star-waroobah/Skyline/README.md

# Skyline





Skyline is a custom flight controller for a quadcopter drone using the STM32F722 microcontroller. It will act as the brain of the drone.

I made this as the half life week 5 project.

## Features

- **STM32F722RET6 MCU** with 25 MHz and 32.768 kHz crystals, plus reset and boot buttons
- **USB-C port** for power and programming
- **4 motor outputs** (PA0–PA3) through one 8-pin 4-in-1 ESC header
- **Receiver header** (UART, 3.3 V) for ELRS or similar radios
- **Battery voltage monitoring**, with the divider sized for a 4S battery
- **SWD header** as a backup way to flash firmware
- **Plug-in IMU (SPI) and barometer (I2C) headers** for breakout boards
- **microSD slot** for flight logging
- **Dual power input:** two SS34 diodes let the board run from USB or the battery
- **LMR51430 3.3 V buck regulator** that accepts up to 36 V in
- **Hand-solderable:** 0603 and 0805 parts and 2.54 mm headers

## How it works

It uses an IMU sensor to detect movement and orientation and a barometer to estimate altitude. The board receive commands from a radio receiver and send signals to four ESCs to control the motors and help keep the drone stable. It also have USB-C for connectivity, a microSD card for flight data logging, and battery voltage monitoring. 

## PCB
Screenshot (659)

## Schematic


## 3D View



## Bill of Materials

Full BOM: [`hardware/BOM.csv`](hardware/BOM.csv)

| Part | Qty | Notes |
|---|-----|---|
| [Microcontroller] | 1 | |
| [IMU / sensor] | 1 | |
| [Motors] | 4 | |
| [ESCs / motor drivers] | 4 | |
| [Battery] | 1 | |
| [Frame] | 1 | |

## Credits

- Symbols and footprints from EasyKiCad2 / EasyEDA converted libraries (included in `hardware/`).
- I also took guidance from the Hack Club guide (https://blueprint.hackclub.com/starter-projects/flightcontroller)
