star-waroobah/Skyline/hardware/skyline.kicad_pcb

## KiCad design hardware/skyline.kicad_pcb (2026-11-08)

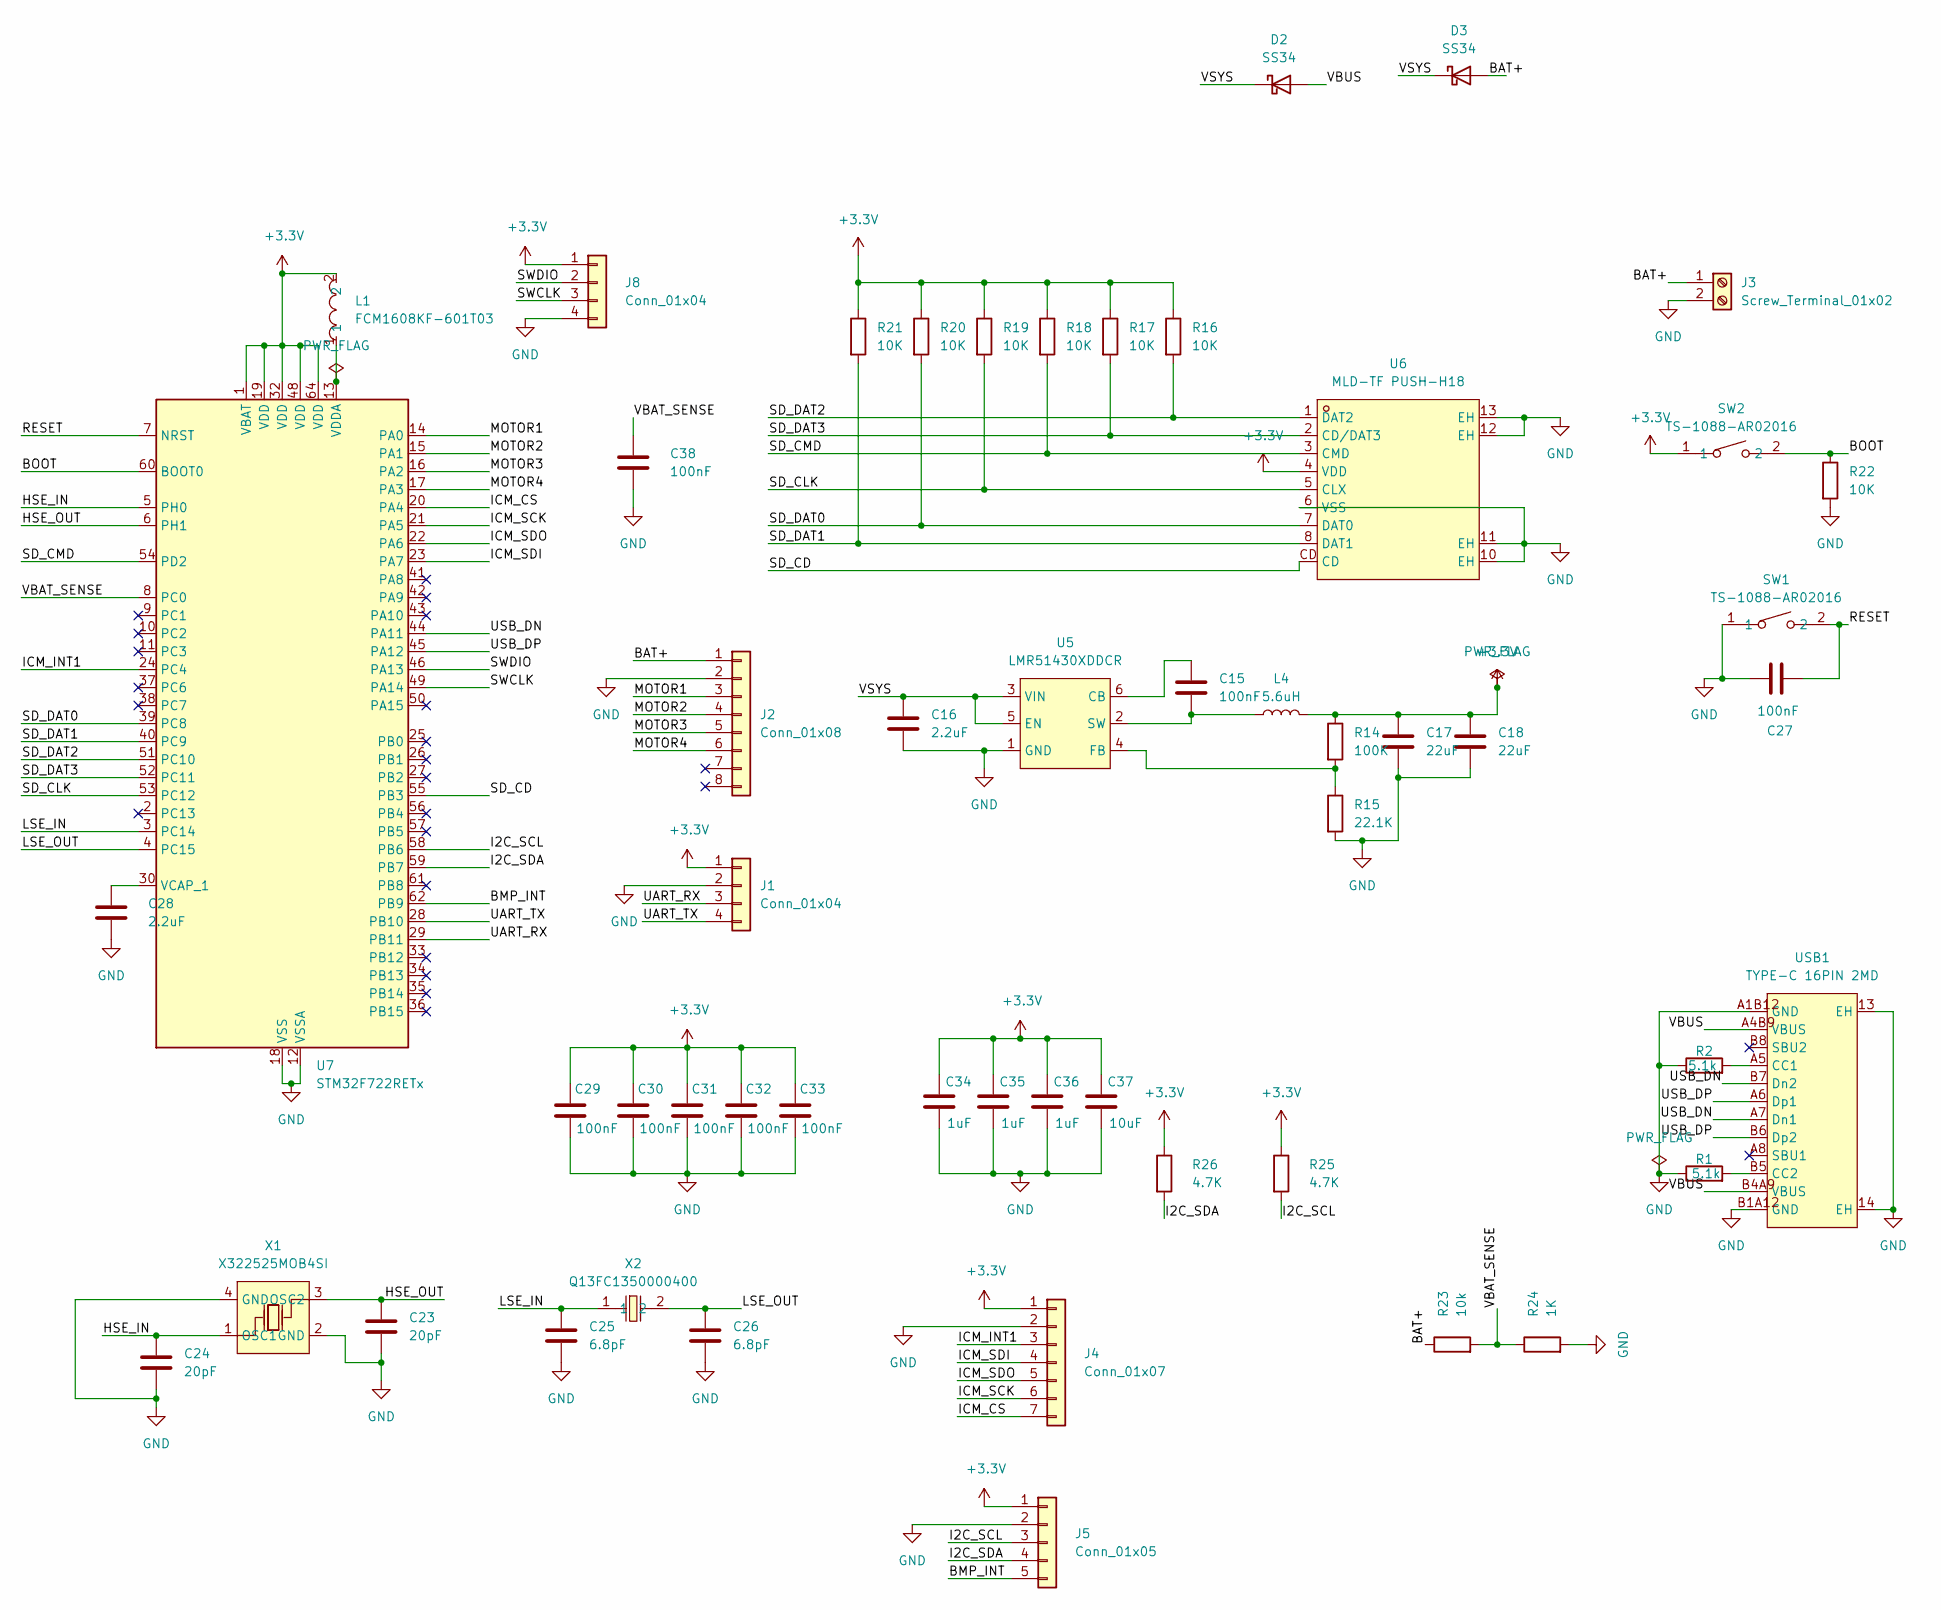
[picture p1: schematic skyline.kicad_sch]

Parts:
C15, C27, C29, C30, C31, C32, C33: 100nF; C_0603_1608Metric
C16, C28: 2.2uF; C_0603_1608Metric
C17, C18: 22uF; C_0603_1608Metric
C23, C24: 20pF; C_0603_1608Metric
C25, C26: 6.8pF; C_0603_1608Metric
C34, C35, C36: 1uF; C_0805_2012Metric
C37: 10uF; C_0603_1608Metric
C38: 100nF; C_0805_2012Metric
D2, D3: SS34; D_SMA
J1, J8: Conn_01x04; PinHeader_1x04_P2.54mm_Vertical
J2: Conn_01x08; PinHeader_1x08_P2.54mm_Vertical
J3: Screw_Terminal_01x02; TerminalBlock_Xinya_XY308-2.54-2P_1x02_P2.54mm_Horizontal
J4: Conn_01x07; PinHeader_1x07_P2.54mm_Vertical
J5: Conn_01x05; PinHeader_1x05_P2.54mm_Vertical
L1: FCM1608KF-601T03; L0603; MPN FCM1608KF-601T03; LCSC Part C141723
L4: 5.6uH; IND-SMD_L3.0-W3.0
R1, R2: 5.1k; R_0603_1608Metric
R14: 100K; R_0603_1608Metric
R15: 22.1K; R_0603_1608Metric
R16, R17, R18, R19, R20, R21, R22: 10K; R_0603_1608Metric
R23: 10k; R_0603_1608Metric
R24: 1K; R_0603_1608Metric
R25, R26: 4.7K; R_0603_1608Metric
SW1, SW2: TS-1088-AR02016; SW-SMD_L3.9-W3.0-P4.45; MPN TS-1088-AR02016; LCSC Part C720477
U5: LMR51430XDDCR; SOT-23-6_L2.9-W1.6-P0.95-LS2.8-BL; MPN LMR51430XDDCR; LCSC Part C5185863
U6: MLD-TF PUSH-H18; SD-SMD_MLD-TF-PUSH-H18; MPN MLD-TF PUSH-H18; LCSC Part C52750848
U7: STM32F722RETx; LQFP-64_10x10mm_P0.5mm
USB1: TYPE-C 16PIN 2MD; USB-C-SMD_TYPE-C-16PIN-2MD-073; MPN TYPE-C 16PIN 2MD(073); LCSC Part C2765186
X1: X322525MOB4SI; CRYSTAL-SMD_4P-L3.2-W2.5-BL; MPN X322525MOB4SI; LCSC Part C9006
X2: Q13FC1350000400; FC-135R_L3.2-W1.5; MPN Q13FC13500004; LCSC Part C32346

Connections:
+3.3V: C17.1, C18.1, C29.1, C30.1, C31.1, C32.1, C33.1, C34.1, C35.1, C36.1, C37.1, J1.1, J4.1, J5.1, J8.1, L1.2, L4.2, R14.1, R16.1, R17.1, R18.1, R19.1, R20.1, R21.1, R25.1, R26.1, SW2.1, U6.4 (VDD), U7.1 (VBAT), U7.19 (VDD), U7.32 (VDD), U7.48 (VDD), U7.64 (VDD)
/<NO NET>: D2.2 (A), USB1.A4B9 (VBUS), USB1.B4A9 (VBUS)
/BAT+: D3.2 (A), J2.1, J3.1, R23.1
/BMP_INT: J5.5, U7.62 (PB9)
/BOOT: R22.1, SW2.2, U7.60 (BOOT0)
/HSE_IN: C24.1, U7.5 (PH0), X1.1 (OSC1)
/HSE_OUT: C23.1, U7.6 (PH1), X1.3 (OSC2)
/I2C_SCL: J5.3, R25.2, U7.58 (PB6)
/I2C_SDA: J5.4, R26.2, U7.59 (PB7)
/ICM_CS: J4.7, U7.20 (PA4)
/ICM_INT1: J4.3, U7.24 (PC4)
/ICM_SCK: J4.6, U7.21 (PA5)
/ICM_SDI: J4.4, U7.23 (PA7)
/ICM_SDO: J4.5, U7.22 (PA6)
/LSE_IN: C25.1, U7.3 (PC14), X2.1
/LSE_OUT: C26.1, U7.4 (PC15), X2.2
/MOTOR1: J2.3, U7.14 (PA0)
/MOTOR2: J2.4, U7.15 (PA1)
/MOTOR3: J2.5, U7.16 (PA2)
/MOTOR4: J2.6, U7.17 (PA3)
/RESET: C27.1, SW1.2, U7.7 (NRST)
/SD_CD: U6.CD, U7.55 (PB3)
/SD_CLK: R19.2, U6.5 (CLX), U7.53 (PC12)
/SD_CMD: R18.2, U6.3 (CMD), U7.54 (PD2)
/SD_DAT0: R20.2, U6.7 (DAT0), U7.39 (PC8)
/SD_DAT1: R21.2, U6.8 (DAT1), U7.40 (PC9)
/SD_DAT2: R16.2, U6.1 (DAT2), U7.51 (PC10)
/SD_DAT3: R17.2, U6.2 (CD/DAT3), U7.52 (PC11)
/SWCLK: J8.3, U7.49 (PA14)
/SWDIO: J8.2, U7.46 (PA13)
/UART_RX: J1.3, U7.29 (PB11)
/UART_TX: J1.4, U7.28 (PB10)
/USB_DN: U7.44 (PA11), USB1.A7 (Dn1), USB1.B7 (Dn2)
/USB_DP: U7.45 (PA12), USB1.A6 (Dp1), USB1.B6 (Dp2)
/VBAT_SENSE: C38.1, R23.2, R24.1, U7.8 (PC0)
/VSYS: C16.1, D2.1 (K), D3.1 (K), U5.3 (VIN), U5.5 (EN)
GND: C16.2, C17.2, C18.2, C23.2, C24.2, C25.2, C26.2, C27.2, C28.2, C29.2, C30.2, C31.2, C32.2, C33.2, C34.2, C35.2, C36.2, C37.2, C38.2, J1.2, J2.2, J3.2, J4.2, J5.2, J8.4, R1.1, R2.1, R15.2, R22.2, R24.2, SW1.1, U5.1 (GND), U6.6 (VSS), U6.10 (EH), U6.11 (EH), U6.12 (EH), U6.13 (EH), U7.12 (VSSA), U7.18 (VSS), U7.31 (VSS), U7.47 (VSS), U7.63 (VSS), USB1.13 (EH), USB1.14 (EH), USB1.A1B12 (GND), USB1.B1A12 (GND), X1.2 (GND), X1.4 (GND)
unnamed: C15.1, U5.6 (CB)
unnamed: R14.2, R15.1, U5.4 (FB)
unnamed: C15.2, L4.1, U5.2 (SW)
unnamed: C28.1, U7.30 (VCAP_1)
unnamed: L1.1, U7.13 (VDDA)
unnamed: R2.2, USB1.A5 (CC1)
unnamed: R1.2, USB1.B5 (CC2)

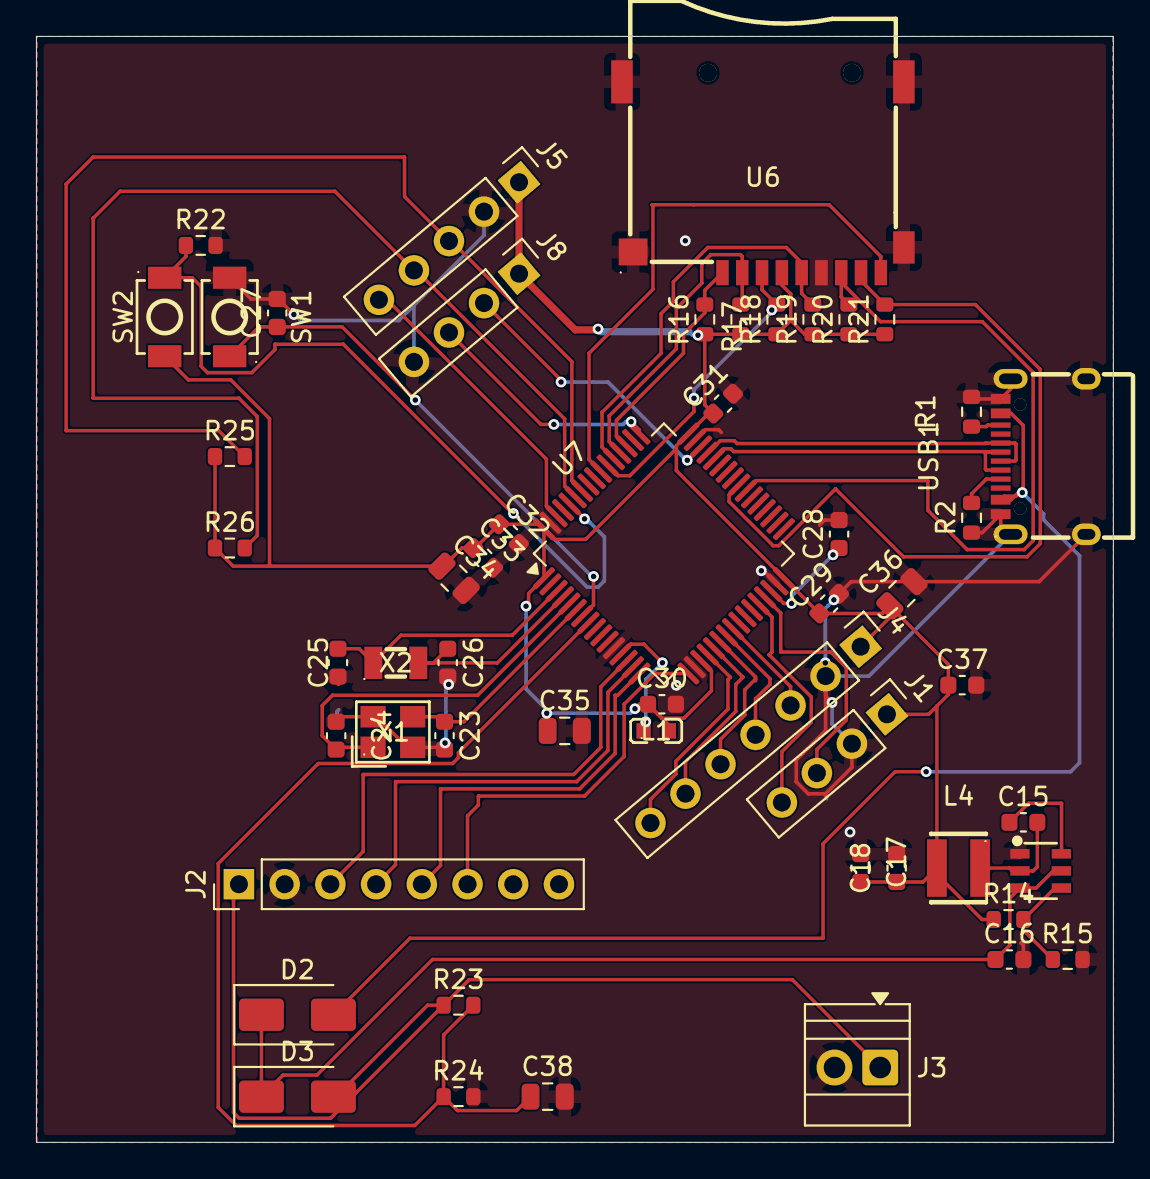
[picture p2: board skyline.kicad_pcb from above]

Board: 2 copper layers, 59.8 x 61.4 mm, 53 parts (0 on the bottom side), 44 nets.
